openlaserfrag/OpenLaserFrag/README.md

# OpenLaserFrag
A laser tag system similar to MILES, for both indoor and outdoor applications. Modular and built on a microcontroller-independent interface.

[Join the OpenLaserFrag chat](https://openlaserfrag.slack.com/)
