openlaserfrag/OpenLaserFrag/hardware/SensorNode.pdf

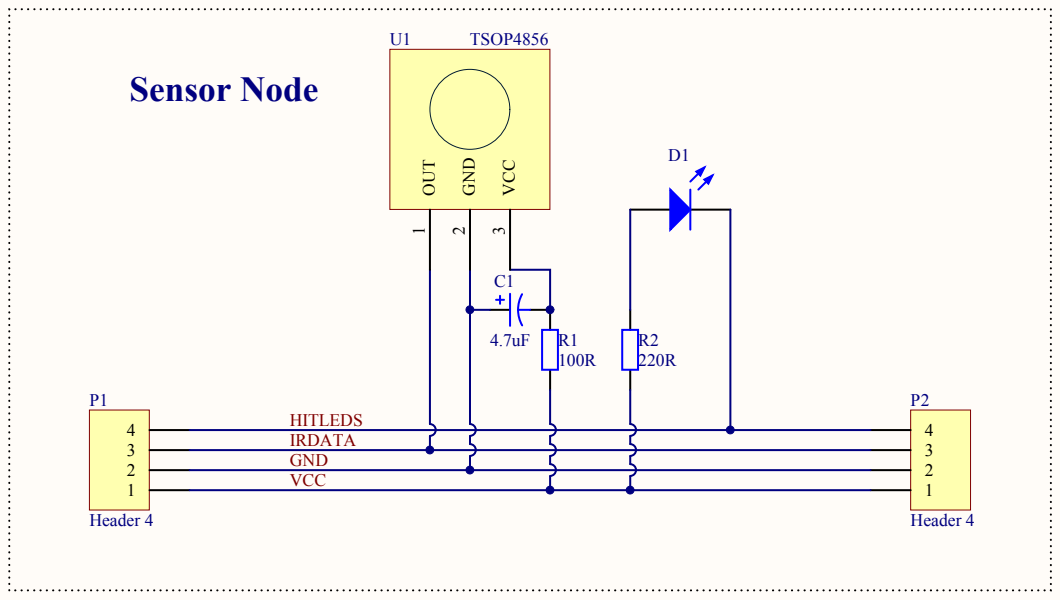
[picture p5: page 1]
Date:; Sheet of File:; C:\Documents and Settings\..\sensor_node.SchDoc Drawn By; Bianco Zandbergen; Header 4; OUT 1; VCC 3; GND 2; Sensor Node

Title
OpenLaserFrag - Sensor Unit and Sensor Nodes
