openlaserfrag/OpenLaserFrag/hardware/SensorUnit.pdf

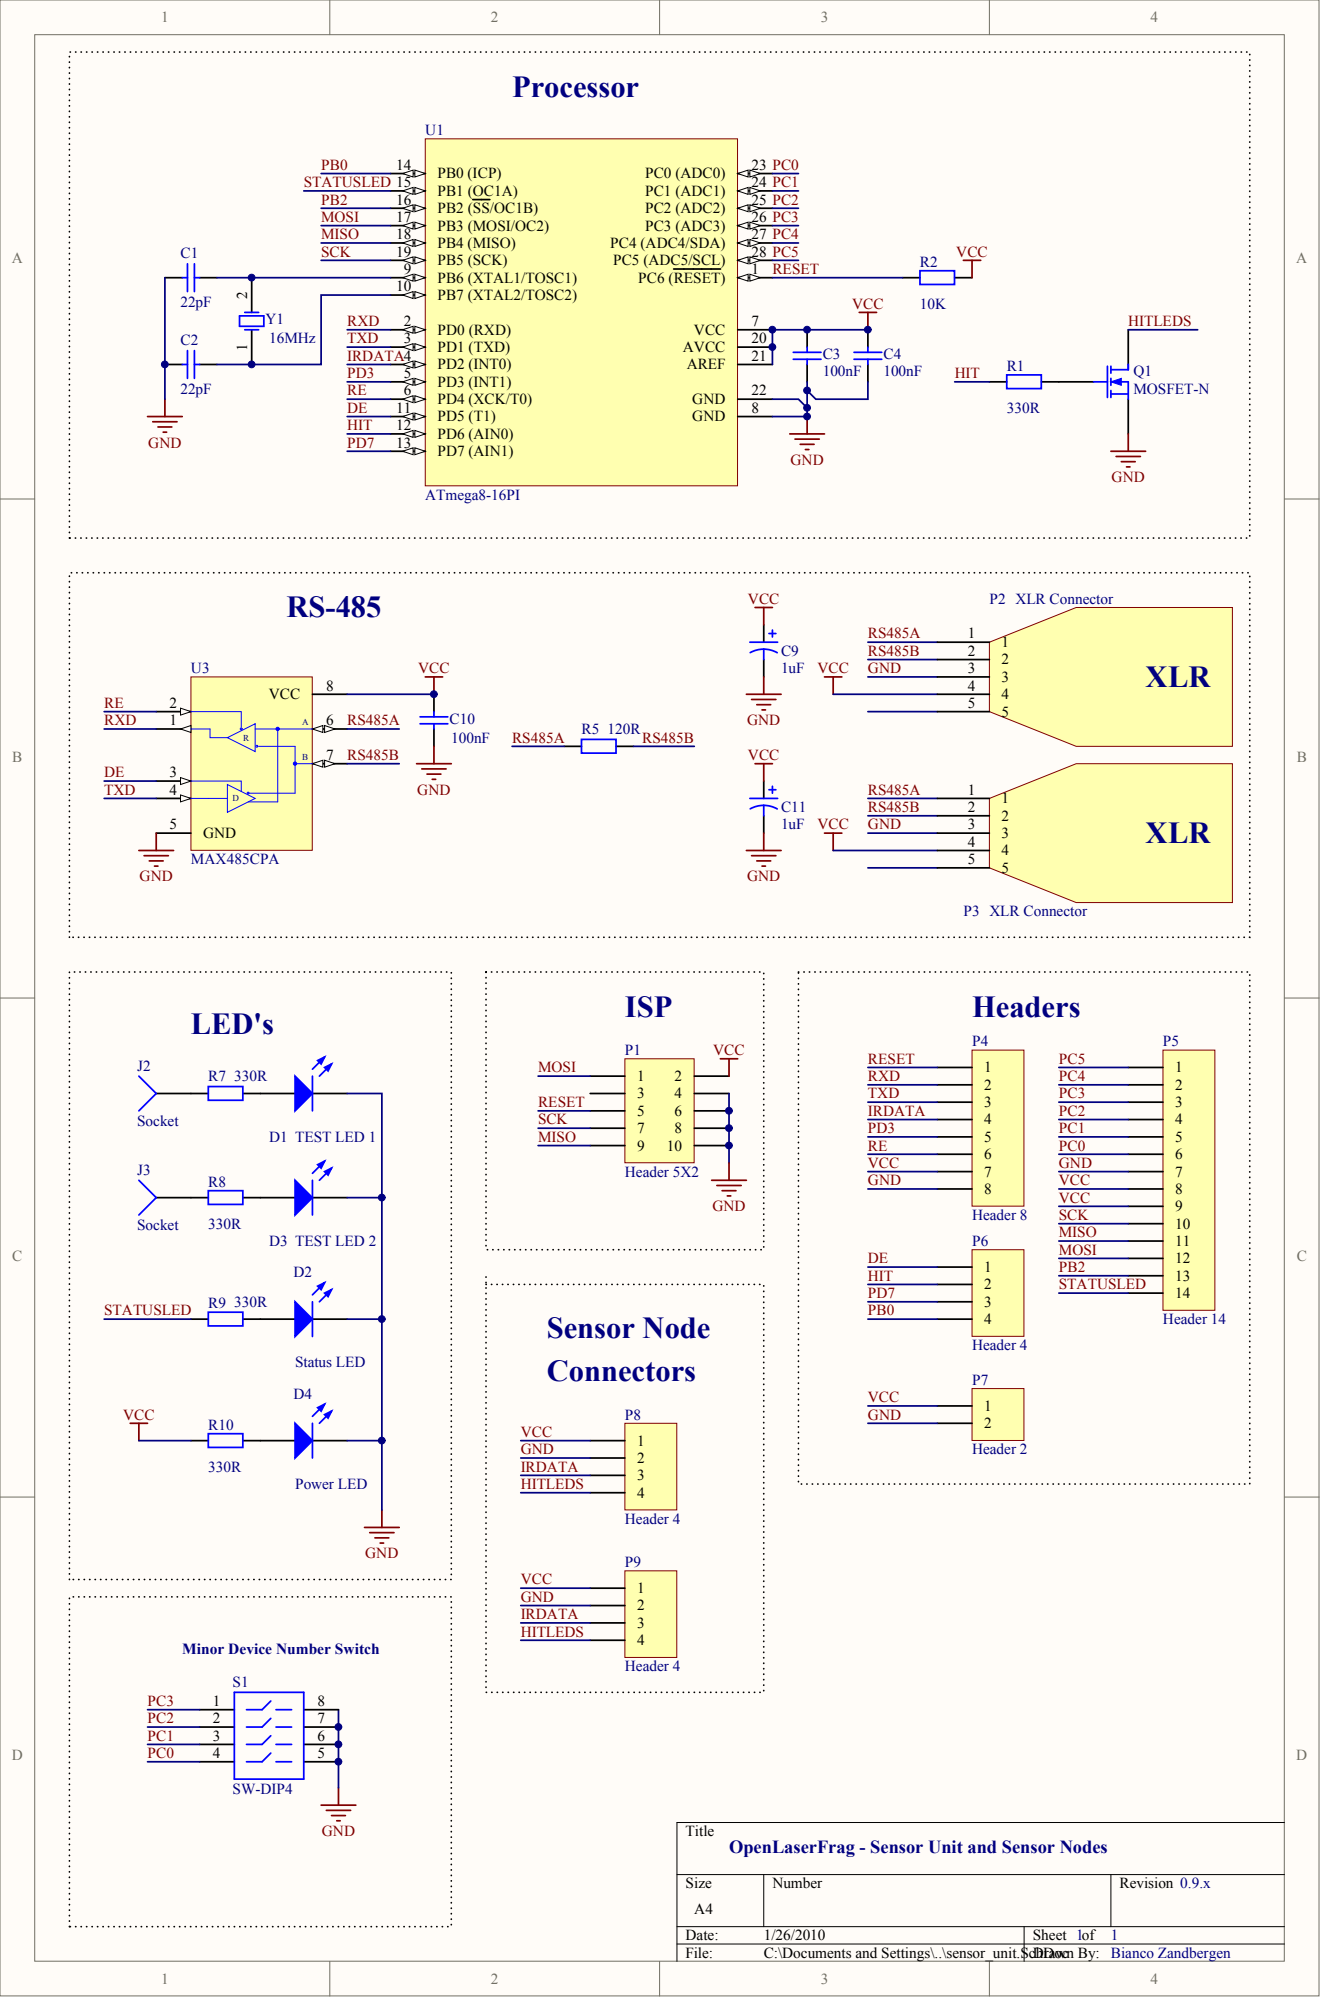
[picture p6: page 1]

Minor Device Number Switch

Title
OpenLaserFrag - Sensor Unit and Sensor Nodes
