openlaserfrag/OpenLaserFrag/hardware/WeaponUnit.pdf

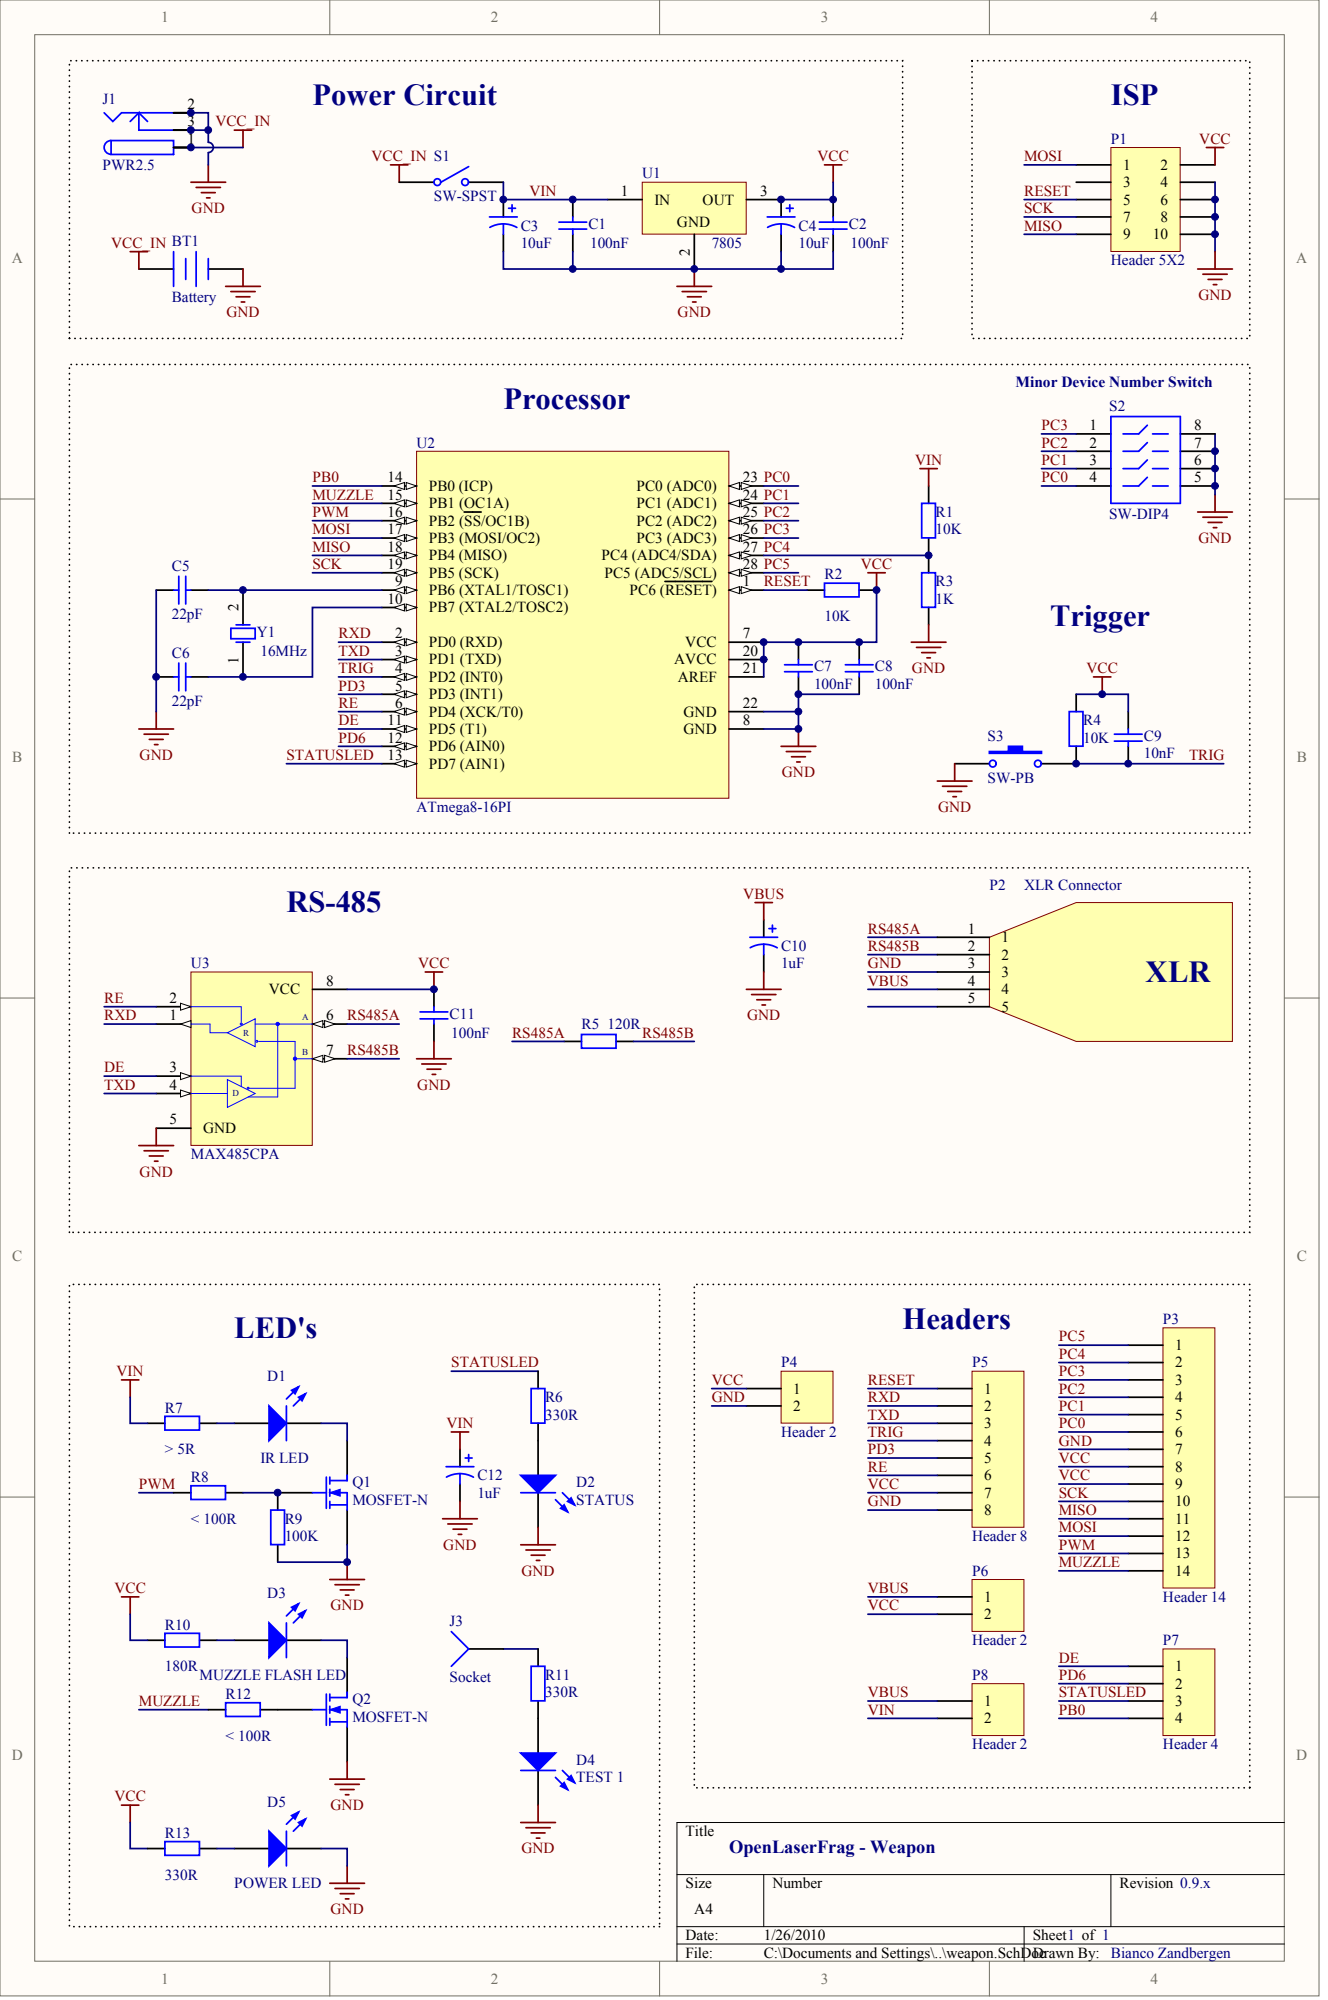
[picture p7: page 1]

Minor Device Number Switch

PD0 (RXD) 2 PD1 (TXD) 3 PD2 (INT0) 4 P0U204 N0TRIG

PD6 N0PD6 STATUSLED N0STATUSLED | PD3 (INT1) 5 P0U205 N0PD3 PD4 (XCK/T0) 6 PD5 (T1) 11 PD6 (AIN0) 12 P0U2012 N0PD6 P0U2013 N0STATUSLED | 100nF
