openlaserfrag/OpenLaserFrag/hardware/PersonalUnit.pdf

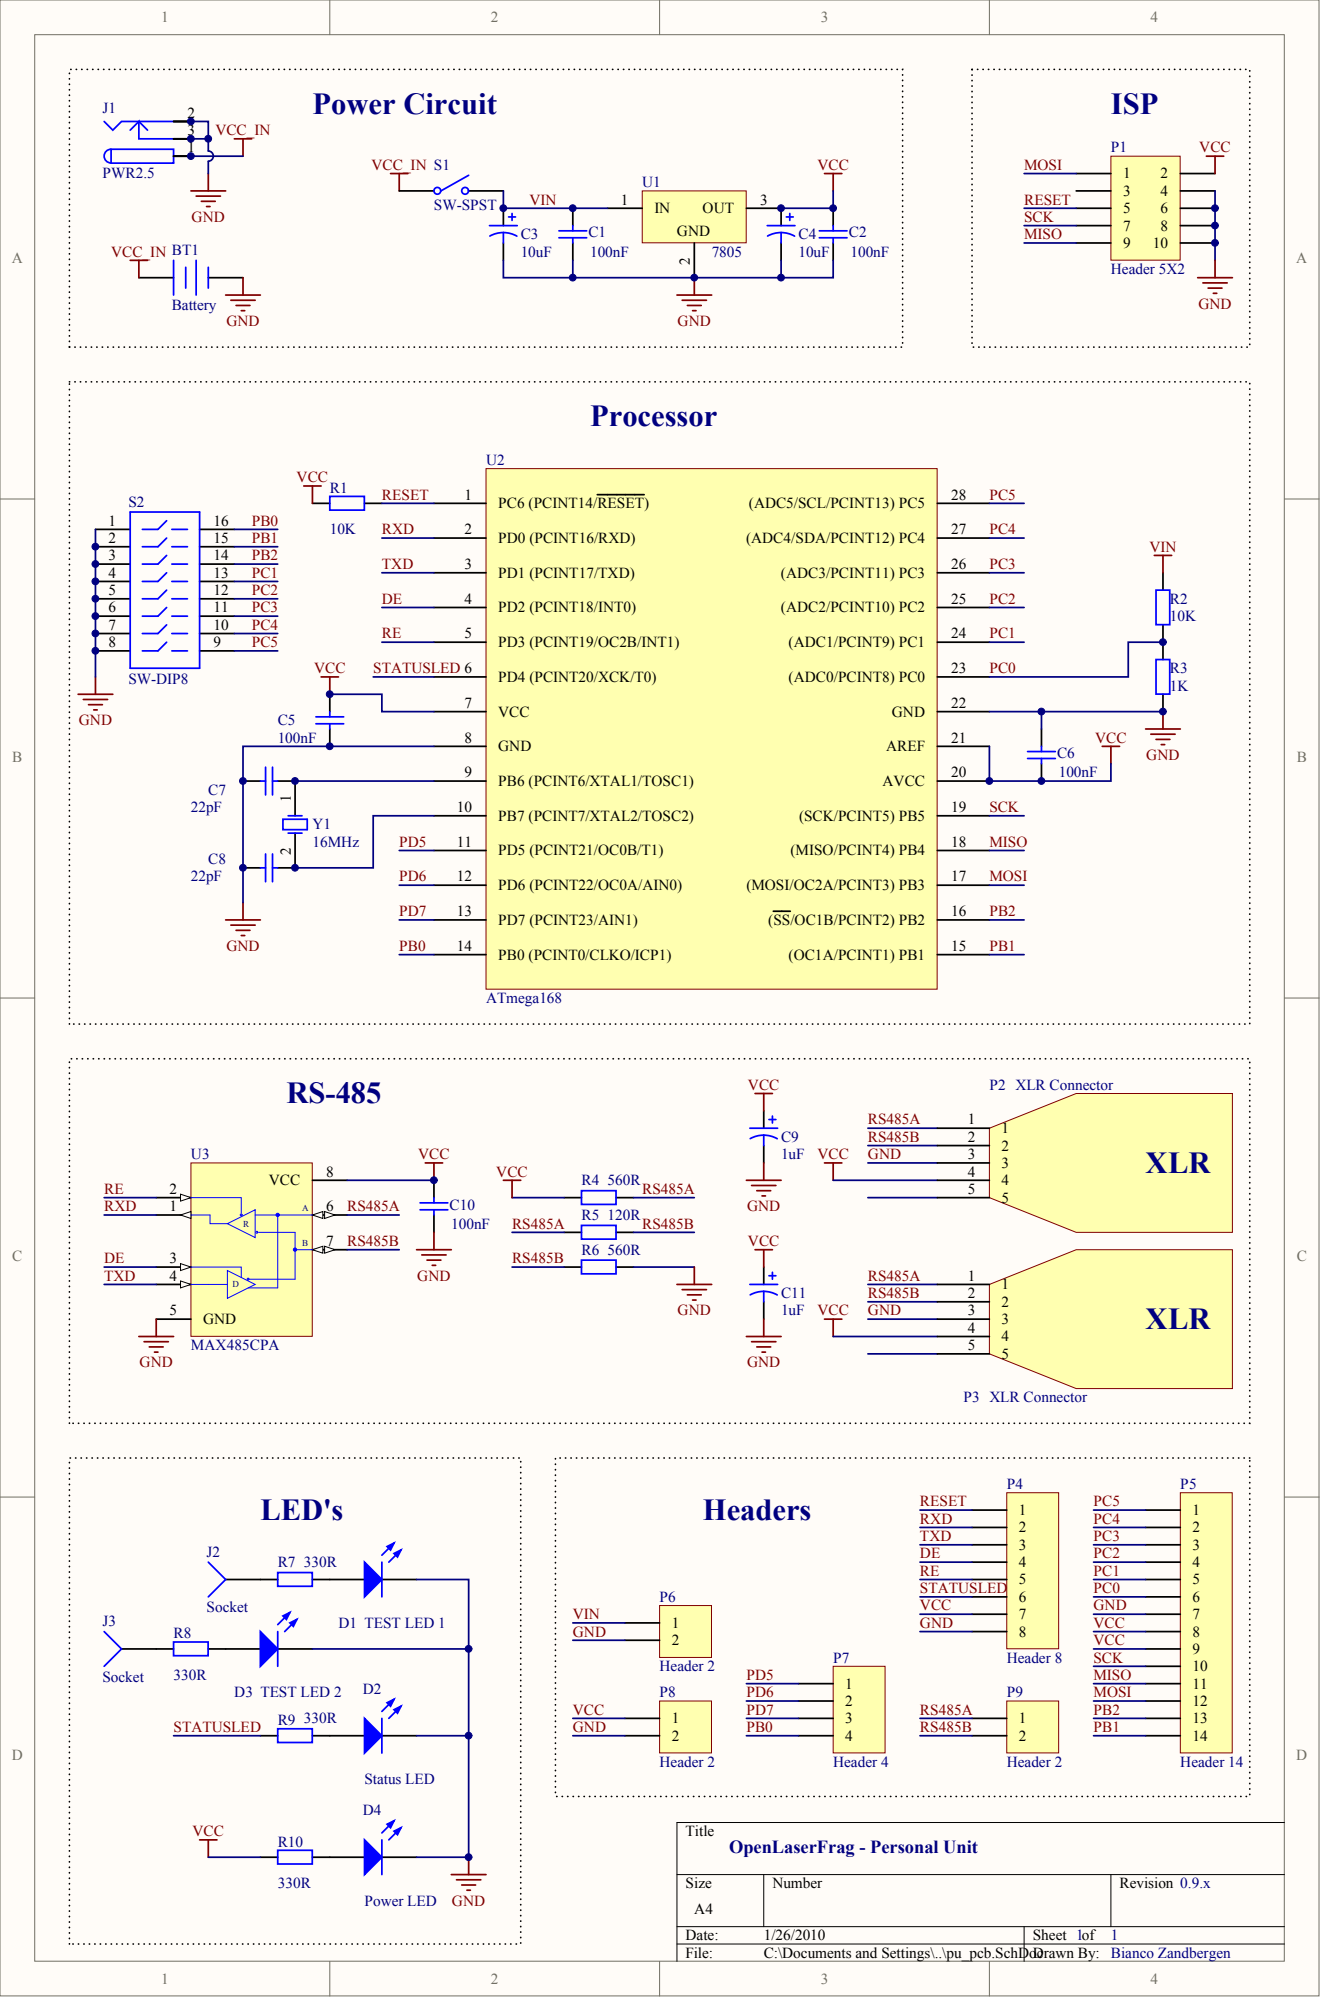
[picture p8: page 1]

2 P0S202 P0S202 P0S202 | P0S2015 P0S2015 P0S2015 15 PB1 N0PB1 N0PB1
3 P0S203 P0S203 P0S203 | P0S2014 P0S2014 P0S2014 14 PB2 N0PB2 N0PB2
4 P0S204 P0S204 P0S204 | P0S2013 P0S2013 P0S2013 13 PC1 N0PC1 N0PC1
5 P0S205 P0S205 P0S205 | P0S2012 P0S2012 P0S2012 12 PC2 N0PC2 N0PC2
6 P0S206 P0S206 P0S206 | P0S2011 P0S2011 P0S2011 11 PC3 N0PC3 N0PC3
7 P0S207 P0S207 P0S207 | P0S2010 P0S2010 P0S2010 10 PC4 N0PC4 N0PC4
